interceptorcool/flyled/hw/oput/fly_ledb.png

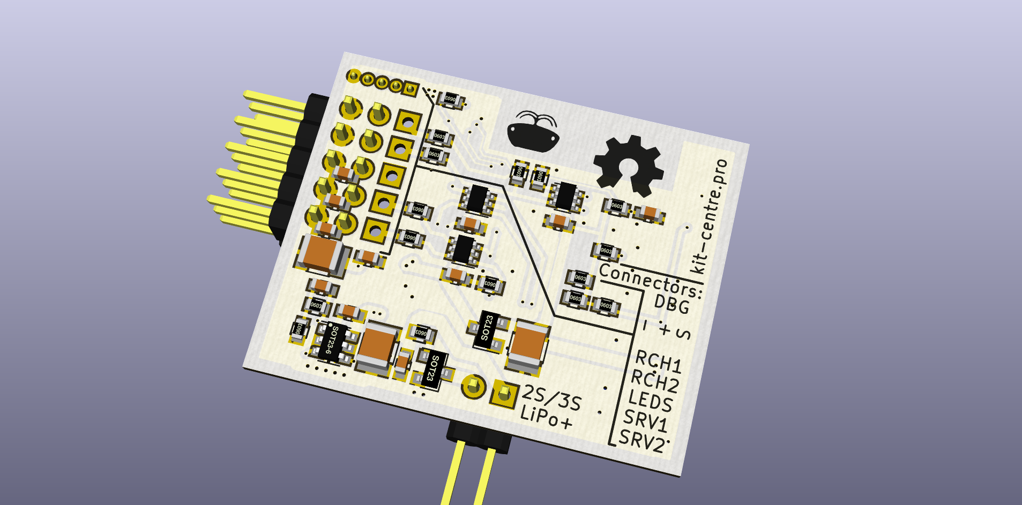
hw/oput/fly_ledb.png
