interceptorcool/flyled/hw/oput/fly_led.png

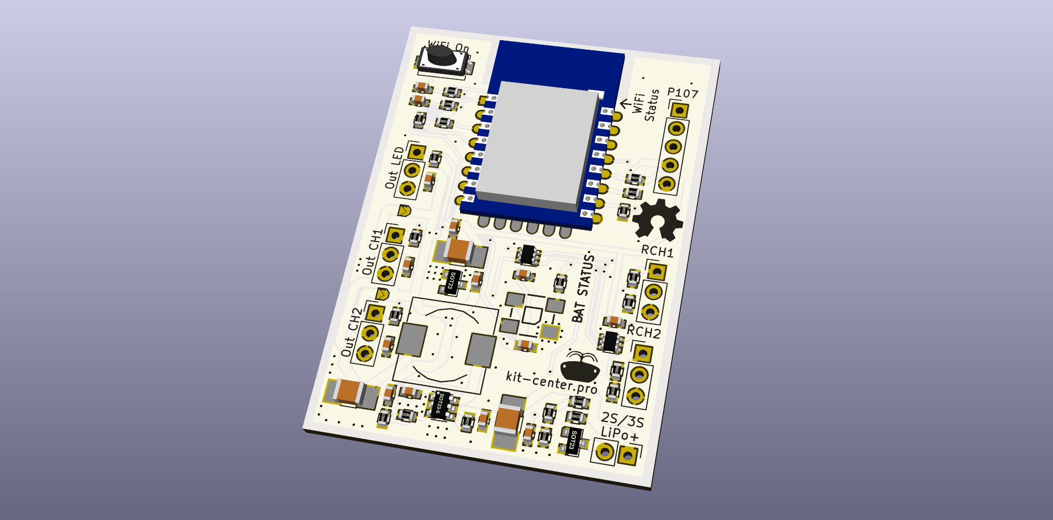
hw/oput/fly_led.png
