interceptorcool/flyled/README.md

# flyled
Fly Led controller for WS281x

# Manual for config - temp_config/conf_prototype.txt

main module esp8266

Libraries:

JsonFiles:
https://bblanchon.github.io/ArduinoJson

NeoPixelBus:
https://github.com/Makuna/NeoPixelBus

# change
global config: "INPUTS"

# add
action class: "RAND"
