interceptorcool/flyled/hw/oput/board/Снимок экрана от 2017-03-02 04:10:03.png

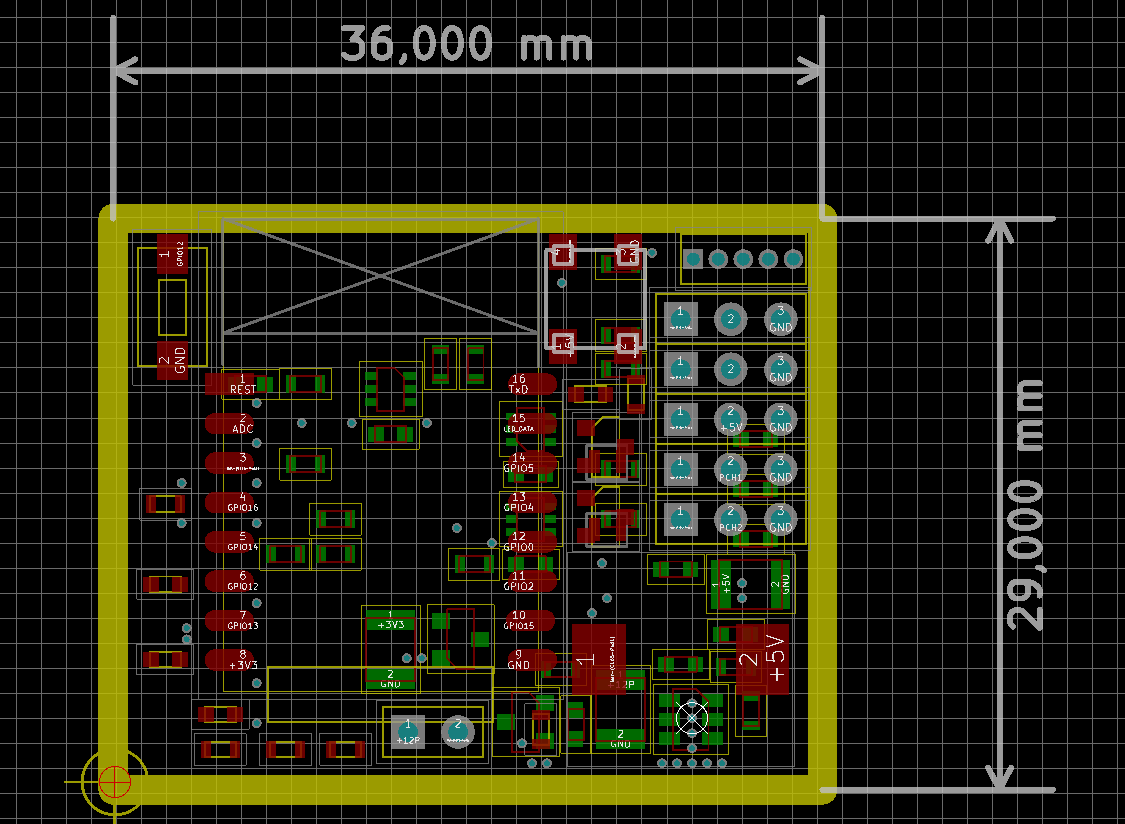
hw/oput/board/Снимок экрана от 2017-03-02 04:10:03.png
