interceptorcool/flyled/hw/oput/fly_led1.jpg

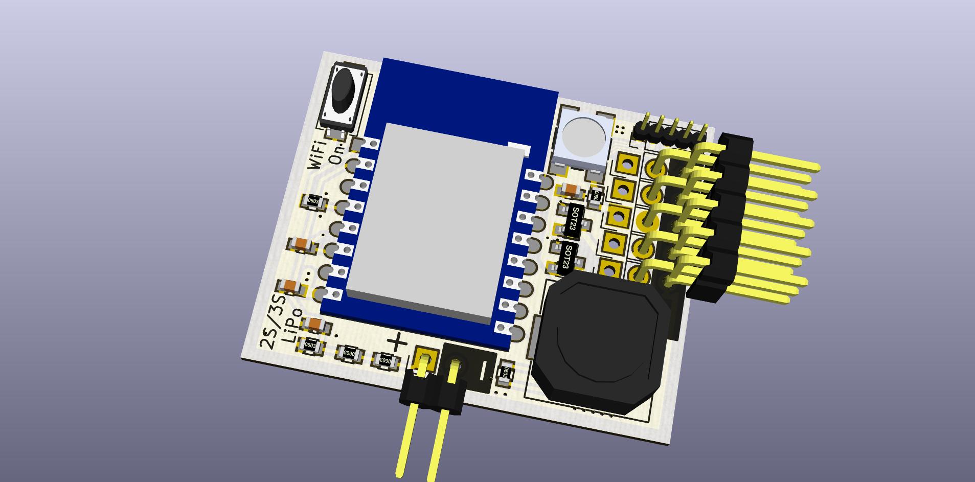
hw/oput/fly_led1.jpg
