interceptorcool/flyled/hw/oput/fly_led2.jpg

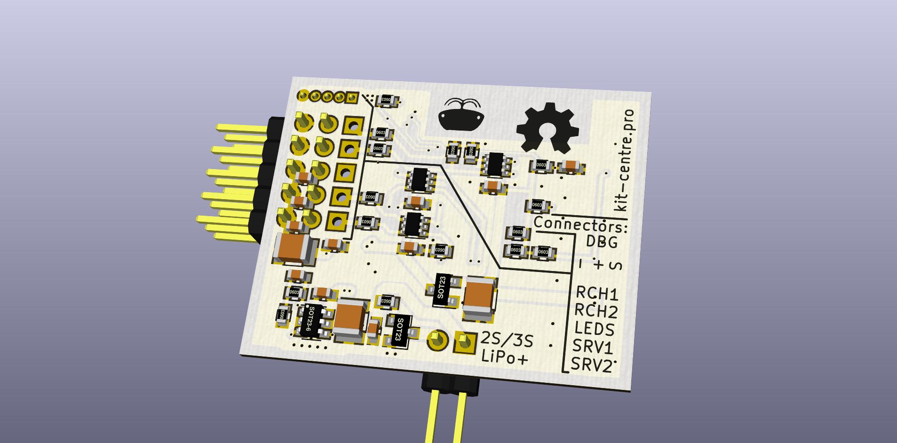
hw/oput/fly_led2.jpg
