interceptorcool/flyled/hw/oput/fly_ledt.png

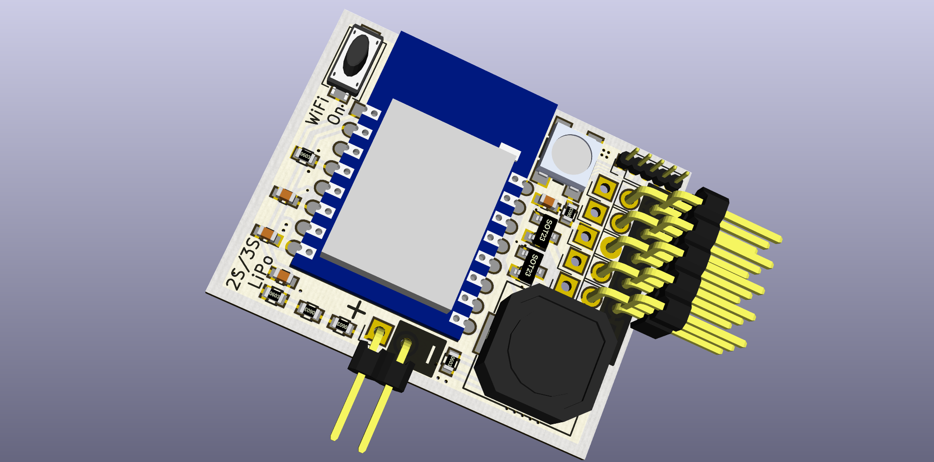
hw/oput/fly_ledt.png
