interceptorcool/flyled/hw/bom/bom1.xlsx

Reference | Value | Footprint | Datasheet | MF# | Ex
L501 | 2.2uH |  | http://www.compel.ru/infosheet/COIL/XFL4020-222MEC
U701 | MAX3222/SSOP-20 | SSOP-20 | http://www.compel.ru/infosheet/TI/MAX3222IDB
U201 | STM32L051C8T6 | LQFP48 | http://www.compel.ru/infosheet/ST/STM32L051C8T6
D501 | TLV62130 |  | http://www.compel.ru/infosheet/TI/TLV62130RGTT
D202 | TVS DIODE 15V |  | http://www.compel.ru/infosheet/ONS/MMBZ15VALT1G | LXES03AAA1-098
D601 | TVS DIODE 15V |  | http://www.compel.ru/infosheet/ONS/MMBZ15VALT1G | LXES03AAA1-098
D602 | TVS DIODE 15V |  | http://www.compel.ru/infosheet/ONS/MMBZ15VALT1G | LXES03AAA1-098
D603 | TVS DIODE 15V |  | http://www.compel.ru/infosheet/ONS/MMBZ15VALT1G | LXES03AAA1-098
D701 | TVS DIODE 15V |  | http://www.compel.ru/infosheet/ONS/MMBZ15VALT1G | LXES03AAA1-098
D702 | TVS DIODE 15V |  | http://www.compel.ru/infosheet/ONS/MMBZ15VALT1G | LXES03AAA1-098
D703 | TVS DIODE 15V |  | http://www.compel.ru/infosheet/ONS/MMBZ15VALT1G | LXES03AAA1-098
D801 | TVS DIODE 15V |  | http://www.compel.ru/infosheet/ONS/MMBZ15VALT1G | LXES03AAA1-098
D802 | TVS DIODE 15V |  | http://www.compel.ru/infosheet/ONS/MMBZ15VALT1G | LXES03AAA1-098
X201 | 32768HZ |  | http://www.compel.ru/infosheet/GEYER/KX-327NHT%2032.768%20kHz
C1001 | 0.1UF
C1002 | 0.1UF
C1003 | 0.1UF
C1004 | 0.1UF
C1201 | 0.1UF | Capacitors_SMD:C_0603
C1202 | 0.1uF | Capacitors_SMD:C_0603
C1203 | 0.1uF | Capacitors_SMD:C_0603
C1204 | 0.1uF | Capacitors_SMD:C_0603
C1205 | 0.1uF | Capacitors_SMD:C_0603
C1206 | 0.1uF | Capacitors_SMD:C_0603
C1207 | 0.1uF | Capacitors_SMD:C_0603
C1208 | 0.1uF | Capacitors_SMD:C_0603
C1211 | 0.1uF | Capacitors_SMD:C_0603
C1212 | 0.1uF | Capacitors_SMD:C_0603
C1215 | 0.1uF | Capacitors_SMD:C_0603
C201 | 0.1UF
C204 | 0.1UF
C206 | 0.1UF
C207 | 0.1UF
C208 | 0.1UF
C209 | 0.1UF
C210 | 0.1UF
C503 | 0.1UF
C605 | 0.1UF | Capacitors_SMD:C_0805
C701 | 0.1UF
C702 | 0.1UF
C703 | 0.1UF
C704 | 0.1UF
R1009 | 1.2M
R1013 | 1.2M
R1001 | 1.8M
R1004 | 1.8M
R1007 | 1.8M
R1011 | 1.8M
R1101 | 1.8M
R1102 | 1.8M
R1103 | 1.8M
R1104 | 1.8M
R1201 | 1.8M
R1301 | 1.8M
R1302 | 1.8M
R502 | 1.8M
R601 | 1.8M
R703 | 1.8M
R704 | 1.8M
R801 | 1.8M
C604 | 10PF | Capacitors_SMD:C_0805
R1010 | 130K
R1014 | 130K
R1105 | 130K
R1106 | 130K
R1211 | 130K | Resistors_SMD:R_0603
R1303 | 130K
R202 | 130K
R203 | 130K
R503 | 130K
R505 | 160K
R201 | 1K
R607 | 1K
R610 | 1K
R611 | 1K
R612 | 1K
R613 | 1K
R614 | 1K
R615 | 1K | Resistors_SMD:R_0805
C1209 | 1uF | Capacitors_SMD:C_0603
C1210 | 1uF | Capacitors_SMD:C_0603
P204 | 1W
C501 | 2200UFx10V
C202 | 22pF
C203 | 22pF
C603 | 22PF | Capacitors_SMD:C_0805
C801 | 22pF
C802 | 22pF
C205 | 22UF
C502 | 22UF
C505 | 22UF
C506 | 22UF
Q1002 | 2N7002P |  | http://www.digikey.com/product-detail/en/nexperia-usa-inc/2N7002P | 235/1727-1865-2-ND/2779619 | 2N7002P | 235
Q1004 | 2N7002P |  | http://www.digikey.com/product-detail/en/nexperia-usa-inc/2N7002P | 235/1727-1865-2-ND/2779619 | 2N7002P | 235
Q1006 | 2N7002P |  | http://www.digikey.com/product-detail/en/nexperia-usa-inc/2N7002P | 235/1727-1865-2-ND/2779619 | 2N7002P | 235
Q1101 | 2N7002P |  | http://www.digikey.com/product-detail/en/nexperia-usa-inc/2N7002P | 235/1727-1865-2-ND/2779619
Q1102 | 2N7002P |  | http://www.digikey.com/product-detail/en/nexperia-usa-inc/2N7002P | 235/1727-1865-2-ND/2779619
Q1301 | 2N7002P |  | http://www.digikey.com/product-detail/en/nexperia-usa-inc/2N7002P | 235/1727-1865-2-ND/2779619 | 2N7002P | 235
Q501 | 2N7002P |  | http://www.digikey.com/product-detail/en/nexperia-usa-inc/2N7002P | 235/1727-1865-2-ND/2779619 | 2N7002P | 235
R1006 | 300k
R1212 | 39k | Resistors_SMD:R_0603
R1203 | 4.7k | Resistors_SMD:R_0603
R1207 | 4.7k | Resistors_SMD:R_0603
R1208 | 4.7k | Resistors_SMD:R_0603
R1213 | 4.7k | Resistors_SMD:R_0603
R1214 | 4.7k | Resistors_SMD:R_0603
R204 | 4.7K
R301 | 4.7k |  |  |  | Y
R401 | 4.7k |  |  |  | Y
C1213 | 4.7uF | Capacitors_SMD:C_0603
C1214 | 4.7uF | Capacitors_SMD:C_0603
C1216 | 4.7uF | Capacitors_SMD:C_0603
R1107 | 43K
R805 | 43K
R806 | 43K
R1304 | 44R
C504 | 470PF
C601 | 470UF
C602 | 470UF
C507 | 470UFx6V
R1002 | 51R
R1003 | 51R
R1008 | 51R
R1012 | 51R
R1202 | 51R
R205 | 51R
R302 | 51R
R402 | 51R
R602 | 51R
R603 | 51R | Resistors_SMD:R_0805
R604 | 51R | Resistors_SMD:R_0805
R605 | 51R | Resistors_SMD:R_0805
R608 | 51R
R609 | 51R
R701 | 51R
R702 | 51R
R802 | 51R
R501 | 560K
R504 | 560K
R803 | 620R
R804 | 620R
R1005 | 750k
R1209 | 750k | Resistors_SMD:R_0603
R101 | 9.1K
R102 | 9.1K
R1204 | 9.1K | Resistors_SMD:R_0603
R1205 | 9.1K | Resistors_SMD:R_0603
R1206 | 9.1K | Resistors_SMD:R_0603
R1210 | 9.1K | Resistors_SMD:R_0603
R606 | 9.1K | Resistors_SMD:R_0805
R901 | 9.1K
P303 | BAT_C+
P403 | BAT_C+
P302 | BAT+
P402 | BAT+
D101 | BAT54C |  | http://www.digikey.com/product-detail/en/on-semiconductor/BAT54CLT3G/BAT54CLT3GOSTR-ND/1792157 | BAT54CLT3G
D102 | BAT54C |  | http://www.digikey.com/product-detail/en/on-semiconductor/BAT54CLT3G/BAT54CLT3GOSTR-ND/1792157 | BAT54CLT3G
D103 | BAT54C |  | http://www.digikey.com/product-detail/en/on-semiconductor/BAT54CLT3G/BAT54CLT3GOSTR-ND/1792157 | BAT54CLT3G
D201 | BAT54C |  | http://www.digikey.com/product-detail/en/on-semiconductor/BAT54CLT3G/BAT54CLT3GOSTR-ND/1792157 | BAT54CLT3G
P301 | BATTARY_CONNECTOR
P401 | BATTARY_CONNECTOR
BT101 | BATTERY
D1001 | BAV99 |  | http://www.digikey.com/product-detail/en/diodes-incorporated/BAV99-13-F/BAV99-13-FDI-ND/4249870 | BAV99-13-F
D1002 | BAV99 |  | http://www.digikey.com/product-detail/en/diodes-incorporated/BAV99-13-F/BAV99-13-FDI-ND/4249870 | BAV99-13-F
D1003 | BAV99 |  | http://www.digikey.com/product-detail/en/diodes-incorporated/BAV99-13-F/BAV99-13-FDI-ND/4249870 | BAV99-13-F
D1004 | BAV99 |  | http://www.digikey.com/product-detail/en/diodes-incorporated/BAV99-13-F/BAV99-13-FDI-ND/4249870 | BAV99-13-F
D1005 | BAV99 |  | http://www.digikey.com/product-detail/en/diodes-incorporated/BAV99-13-F/BAV99-13-FDI-ND/4249870 | BAV99-13-F
P201 | BOOT
P702 | COM_EN_PWR
P701 | COM_RCV
P207 | CONN_01X05-PRG
P605 | CONN_02X03 | Pin_Headers:Pin_Header_Straight_2x03
P1205 | CONN_02X10
P1206 | CONN_02X10
J701 | DB9-DCE
P502 | DC_EN
P503 | DC_GND
P501 | DC_IN
P504 | DC_OUT
P1301 | DCHG_C
P1303 | DCHG_I-
P1302 | DCHG_I+
D1203 | ESDA5V3SC5 | tgenn:SOT23-5
D1204 | ESDA5V3SC5 | tgenn:SOT23-5
P101 | EXT
U1201 | FSA2567 | tgenn:MLP16B
P1202 | G_En
P1203 | G_GND
P1204 | G_PWR
P1201 | G_PWR_IN
GS1201 | GS2 | icool:Jumper_SOL
GS1202 | GS2 | icool:Jumper_SOL
GS1203 | GS2 | icool:Jumper_SOL
GS1204 | GS2 | icool:Jumper_SOL
P602 | GSM_EN
P603 | GSM_PWR
P601 | GSM_PWR_IN
P202 | I2C_SCL
P203 | I2C_SDA
P802 | IN1
P803 | IN2
Q601 | irlml9303
Q1001 | IRML9303TR |  | http://www.digikey.com/product-detail/en/diodes-incorporated/DMG2301L-13/DMG2301L-13-ND/5768496 | DMG2301L-13
Q1003 | IRML9303TR |  | http://www.digikey.com/product-detail/en/diodes-incorporated/DMG2301L-13/DMG2301L-13-ND/5768496 | DMG2301L-13
Q1005 | IRML9303TR |  | http://www.digikey.com/product-detail/en/diodes-incorporated/DMG2301L-13/DMG2301L-13-ND/5768496 | DMG2301L-13
Q1103 | IRML9303TR |  | http://www.digikey.com/product-detail/en/diodes-incorporated/DMG2301L-13/DMG2301L-13-ND/5768496 | DMG2301L-13
Q1104 | IRML9303TR |  | http://www.digikey.com/product-detail/en/diodes-incorporated/DMG2301L-13/DMG2301L-13-ND/5768496 | DMG2301L-13
Q1105 | IRML9303TR |  | http://www.digikey.com/product-detail/en/diodes-incorporated/DMG2301L-13/DMG2301L-13-ND/5768496 | DMG2301L-13
Q1106 | IRML9303TR |  | http://www.digikey.com/product-detail/en/diodes-incorporated/DMG2301L-13/DMG2301L-13-ND/5768496 | DMG2301L-13
Q1201 | IRML9303TR |  | http://www.digikey.com/product-detail/en/diodes-incorporated/DMG2301L-13/DMG2301L-13-ND/5768496 | DMG2301L-13
Q1302 | IRML9303TR |  | http://www.digikey.com/product-detail/en/diodes-incorporated/DMG2301L-13/DMG2301L-13-ND/5768496 | DMG2301L-13
Q301 | IRML9303TR |  | http://www.digikey.com/product-detail/en/diodes-incorporated/DMG2301L-13/DMG2301L-13-ND/5768496 | DMG2301L-13
Q401 | IRML9303TR |  | http://www.digikey.com/product-detail/en/diodes-incorporated/DMG2301L-13/DMG2301L-13-ND/5768496 | DMG2301L-13
Q801 | IRML9303TR |  | http://www.digikey.com/product-detail/en/diodes-incorporated/DMG2301L-13/DMG2301L-13-ND/5768496 | DMG2301L-13
JP1001 | Jumper_NO_Small
JP1002 | Jumper_NO_Small
JP1003 | Jumper_NO_Small
JP1004 | Jumper_NO_Small
JP1005 | Jumper_NO_Small
JP1006 | Jumper_NO_Small
JP1007 | Jumper_NO_Small
JP101 | Jumper_NO_Small
D301 | LED_RED
D401 | LED_RED
L1201 | LQM21FN2R2N00D | Resistors_SMD:R_0805
L1202 | LQM21FN2R2N00D | Resistors_SMD:R_0805
P1001 | M_CNTR
P1002 | M_M_VBAT1+
P1003 | M_VBAT1_G
P1004 | M_VBAT1_M
P1007 | M_VBAT1_M
P1010 | M_VBAT1_M
P1006 | M_VBAT2_G
P1009 | M_VBAT2_G
P1005 | M_VBAT2+
P1008 | M_VBAT3+
P205 | MCU_GND
P206 | MCU_PWR
U1202 | MTCH102-I/MS-ND | tgenn:MSOP-8
P901 | OUT
P902 | OUT
U901 | PC817 | DIP-4
ANT601 | PCB_ANT | tgenn:PCB_ANTENNA_PAD
P604 | RF_SYNC
P1102 | S_BAT1
P1101 | S_BAT2
P1105 | S_BATO
P1103 | S_CNT0
P1104 | S_CNT1
P801 | S_CNTR
D1201 | SIM_LED
U601 | SIM800H | tgenn:SIM800H
D1202 | STM_LED
S1203 | TSensor_A | Connect:PINTST
S1202 | TSensor_B | Connect:PINTST
S1201 | TSensor_C | Connect:PINTST
OLED1201 | UG-2864HSWEG01 | tgenn:UG-2864HXXX
JP1101 | USB_PON
SK1201 | WM9364CT-ND | tgenn:USIM-MOLEX-0786463001
SK1202 | WM9364CT-ND | tgenn:USIM-MOLEX-0786463001
