interceptorcool/flyled/hw/bom/fly_led.ods

Reference | Quantity | 50 | Package | Value | WorkInfo | AddInfo | Manf# | Manufacture | Specification | RU | errta | MountSide | OR | MF# | DI | PT
U2;U3 | 2 | 100 |  | 74LVC2G34_VCC
U102 | 1 | 50 |  | ESP-12E
U101 | 1 | 50 |  | AP2210N-3.3TRE1
U1 | 1 | 50 |  | 74LVC2G34_VCC |  |  |  |  |  |  |  |  | SN74LVC2G34DCKR
SW101 | 1 | 50 |  | SW_SOFT_POINT |  |  |  |  |  |  |  |  | (TS-1143HSL-180-003) | SWT-10
R122 | 1 | 50 |  | 330R |  |  |  |  |  |  |  |  |  |  |  | NP
R116;R118;R120;R119;R121;R117;R110;R102;R104;R106;R108 | 11 | 550 |  | 10k
R115 | 1 | 50 |  | 15k
R114;R109 | 2 | 100 |  | 110k
R111;R112;R101;R113;R107;R103;R105 | 8 | 400 |  | 330R
Q102;Q103 | 2 | 100 |  | Q_PMOS_GSD
Q101 | 1 | 30 |  | DMG3420U
PJ101;PJ102 | 2 | 100 |  | PJP |  |  |  |  |  |  |  |  | http://www.electronshik.ru/item/plt-81-46636
P107 | 1 | 50 |  | PRG |  |  |  |  |  |  |  |  | Бурый Медведь PLT-81
P106 | 1 | 50 |  | LED_STRIP
P105 | 1 | 50 |  | Servo_CH2
P104 | 1 | 50 |  | Servo_CH1
P103 | 1 | 50 |  | LiPo
P102 | 1 | 50 |  | RCV_CH2
P101 | 1 | 50 |  | RCV_CH1
LED101 | 1 | 50 |  | WS2812B
L101 | 1 | 30 |  | 8.2uH |  |  |  |  |  |  |  |  | IHLP2525CZER8R2M01 | SCRH105RY-8R2 | http://www.digikey.com/product-detail/en/signal-transformer/SCRH105RY-8R2/SCRH105RY-8R2-ND/277889
D101 | 1 | 30 |  | MT2492 |  |  |  |  |  |  |  |  |  | AEROSEMI
C107;C116;C103;C104;C108;C109;C110;C117;C106;C112;C114;C105;C111;C101;C118 | 15 | 750 |  | 100NF
C102;C113;C115 | 3 | 150 |  | 22u |  |  |  |  |  |  |  |  | http://www.compel.ru/infosheet/YAG/CC1210KKX7R7BB226 | CC1210KKX7R7BB226
