interceptorcool/flyled/manual/Doc1.docx

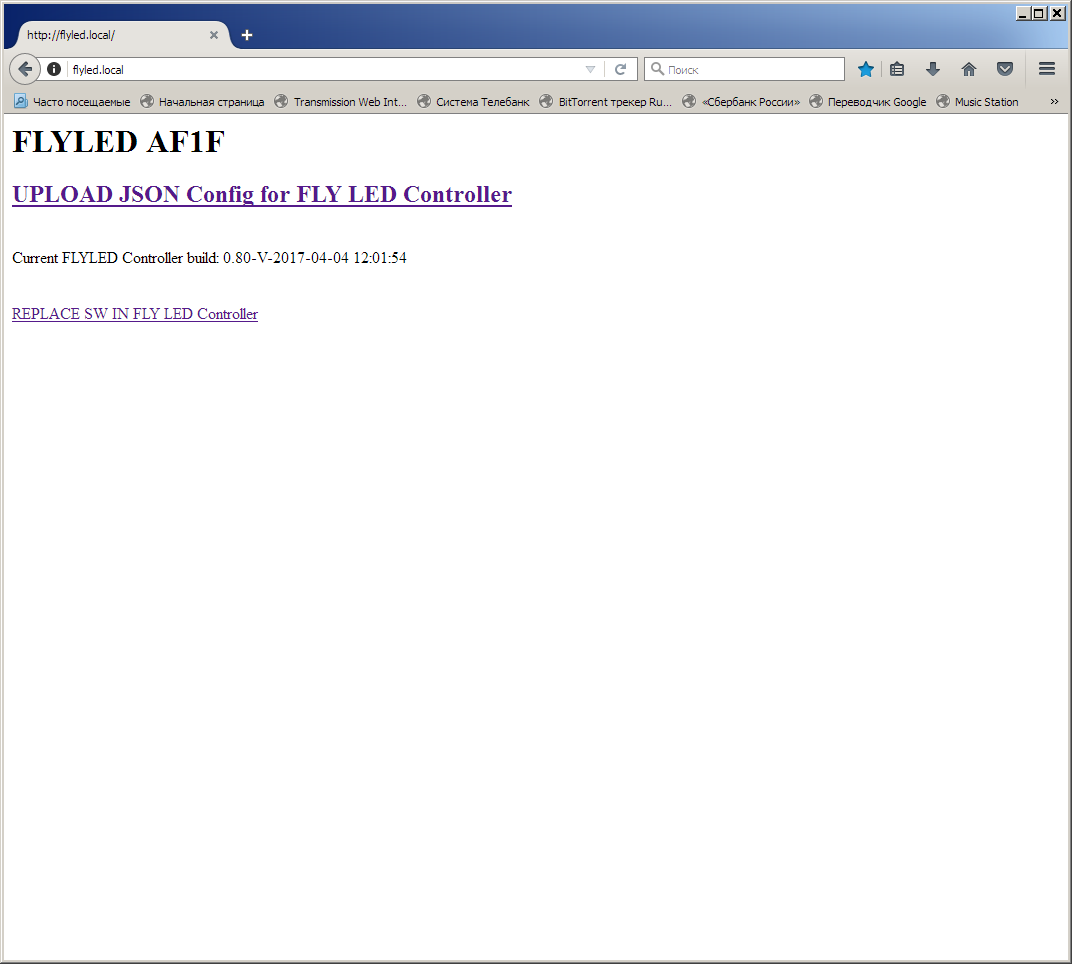
[picture p7: figure]
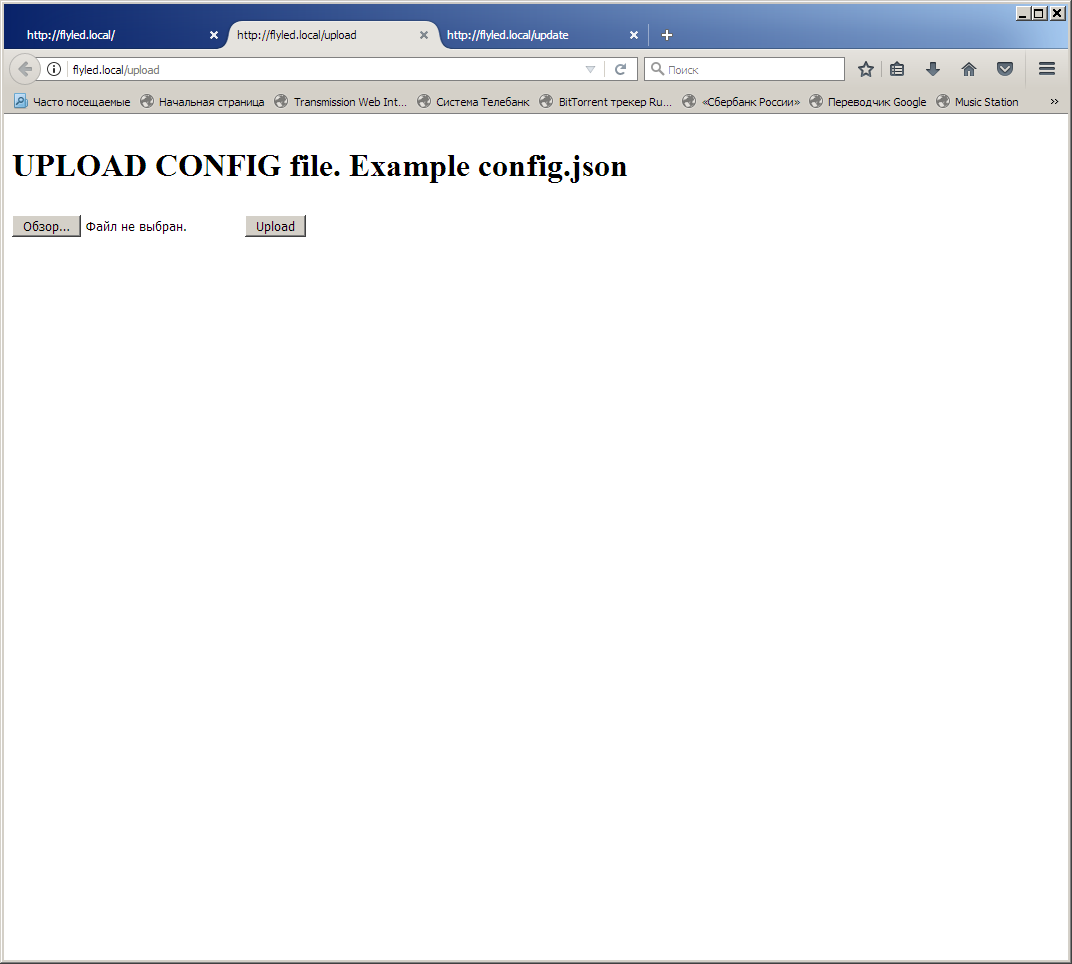
[picture p8: figure]
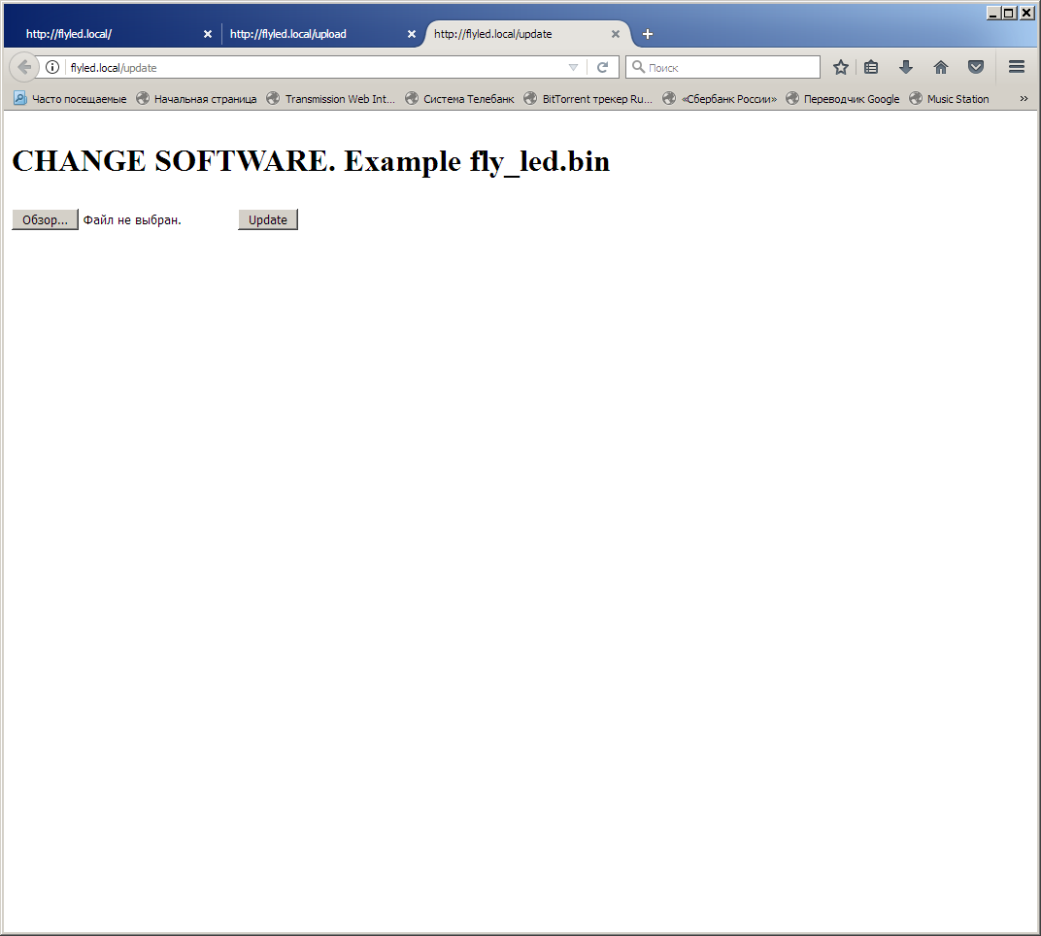
[picture p9: figure]
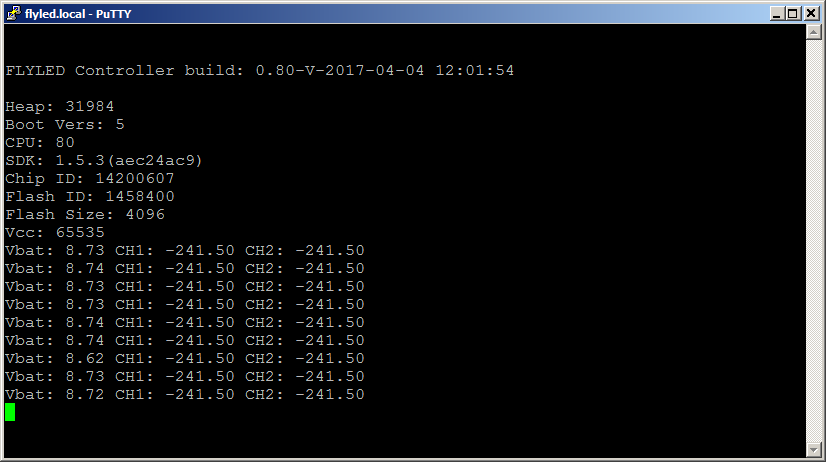
[picture p10: figure]
