interceptorcool/flyled/manual/FLYLED-manual.pdf

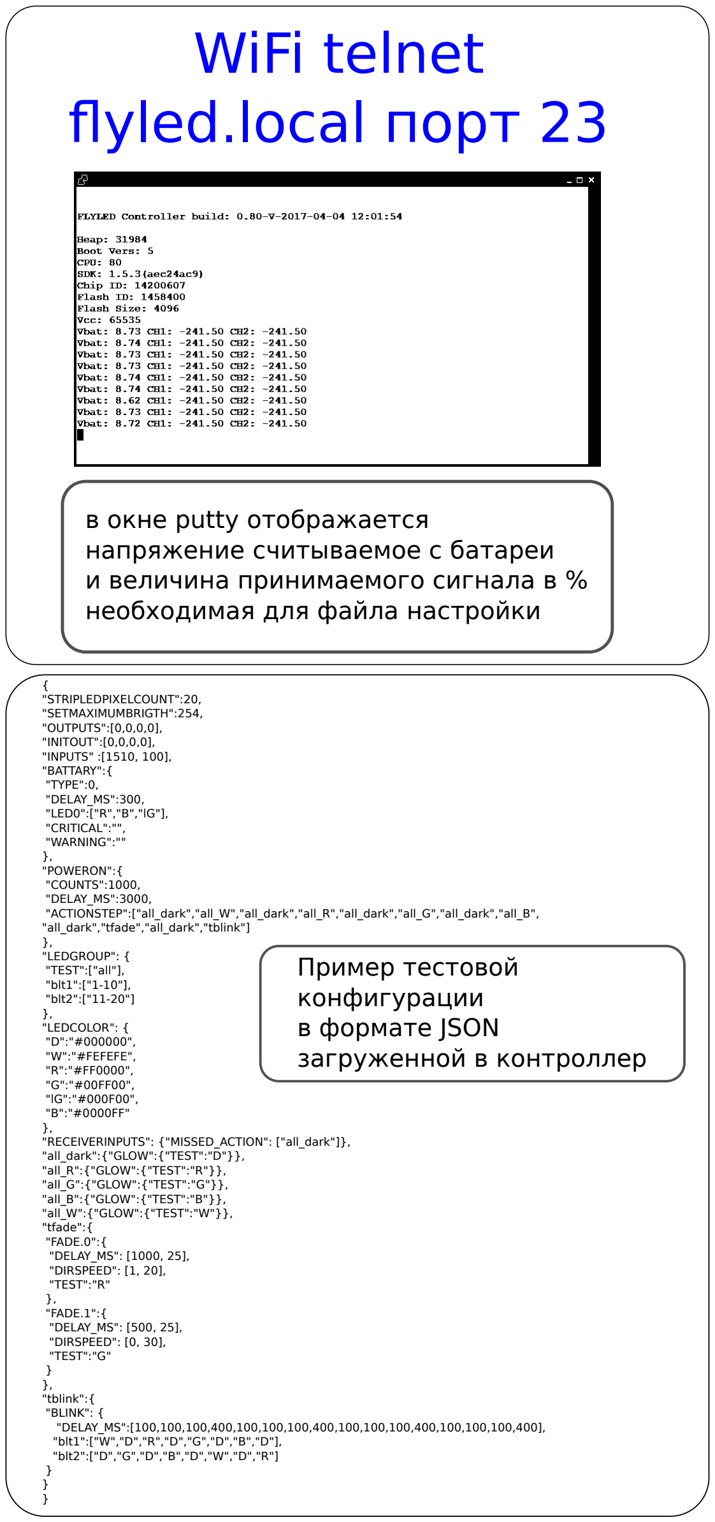
[picture p11: figure]
WiFi telnet flyled.local порт 23; в окне putty отображается напряжение считываемое с батареи и величина принимаемого сигнала в % необходимая для файла настройки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
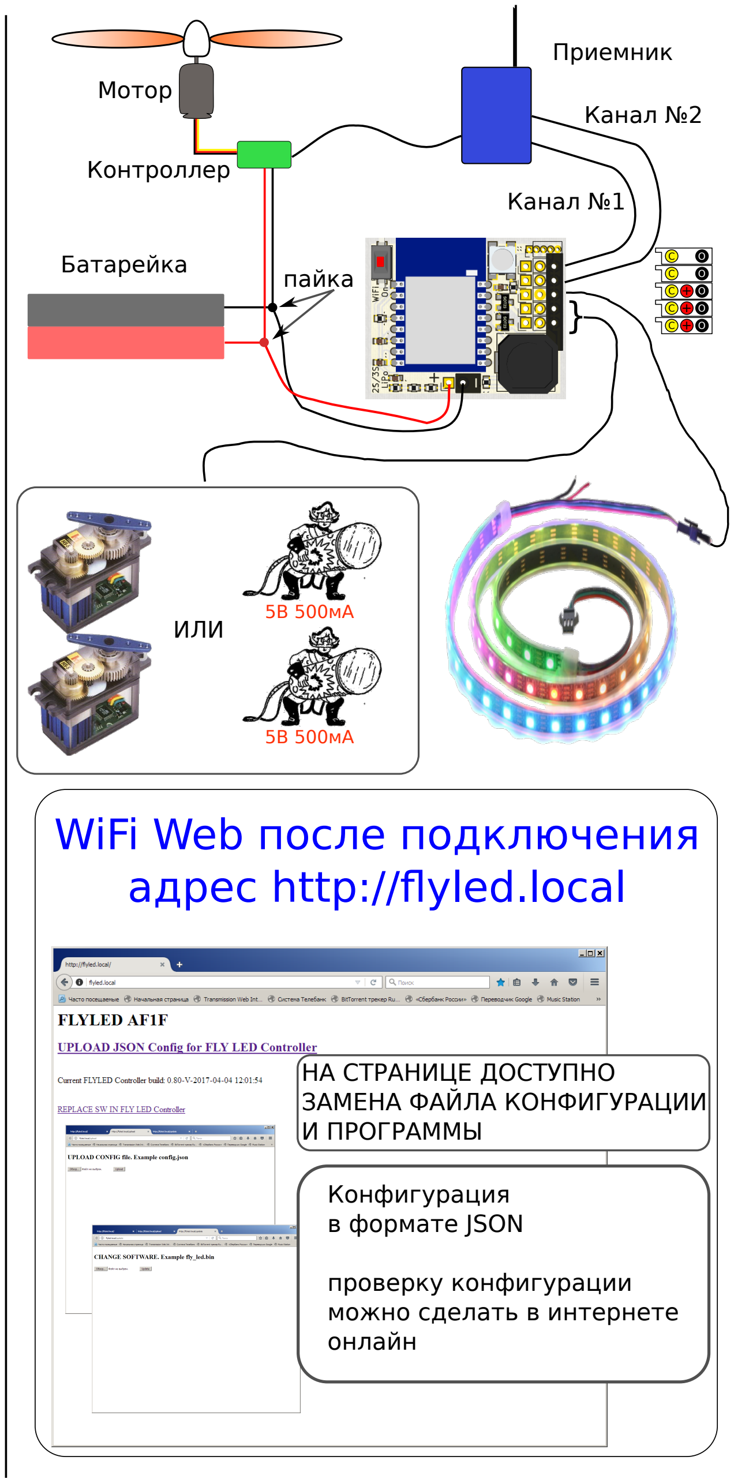
[picture p12: figure]
Контроллер; Мотор; Приемник; Батарейка; пайка; Канал №1; Канал №2; ИЛИ; WiFi Web после подключения адрес http://flyled.local; НА СТРАНИЦЕ ДОСТУПНО ЗАМЕНА ФАЙЛА КОНФИГУРАЦИИ И ПРОГРАММЫ; Конфигурация в формате JSON; проверку конфигурации можно сделать в интернете онлайн

# FLYLED Controller kit-center.pro

## КИТ ЦЕНТР

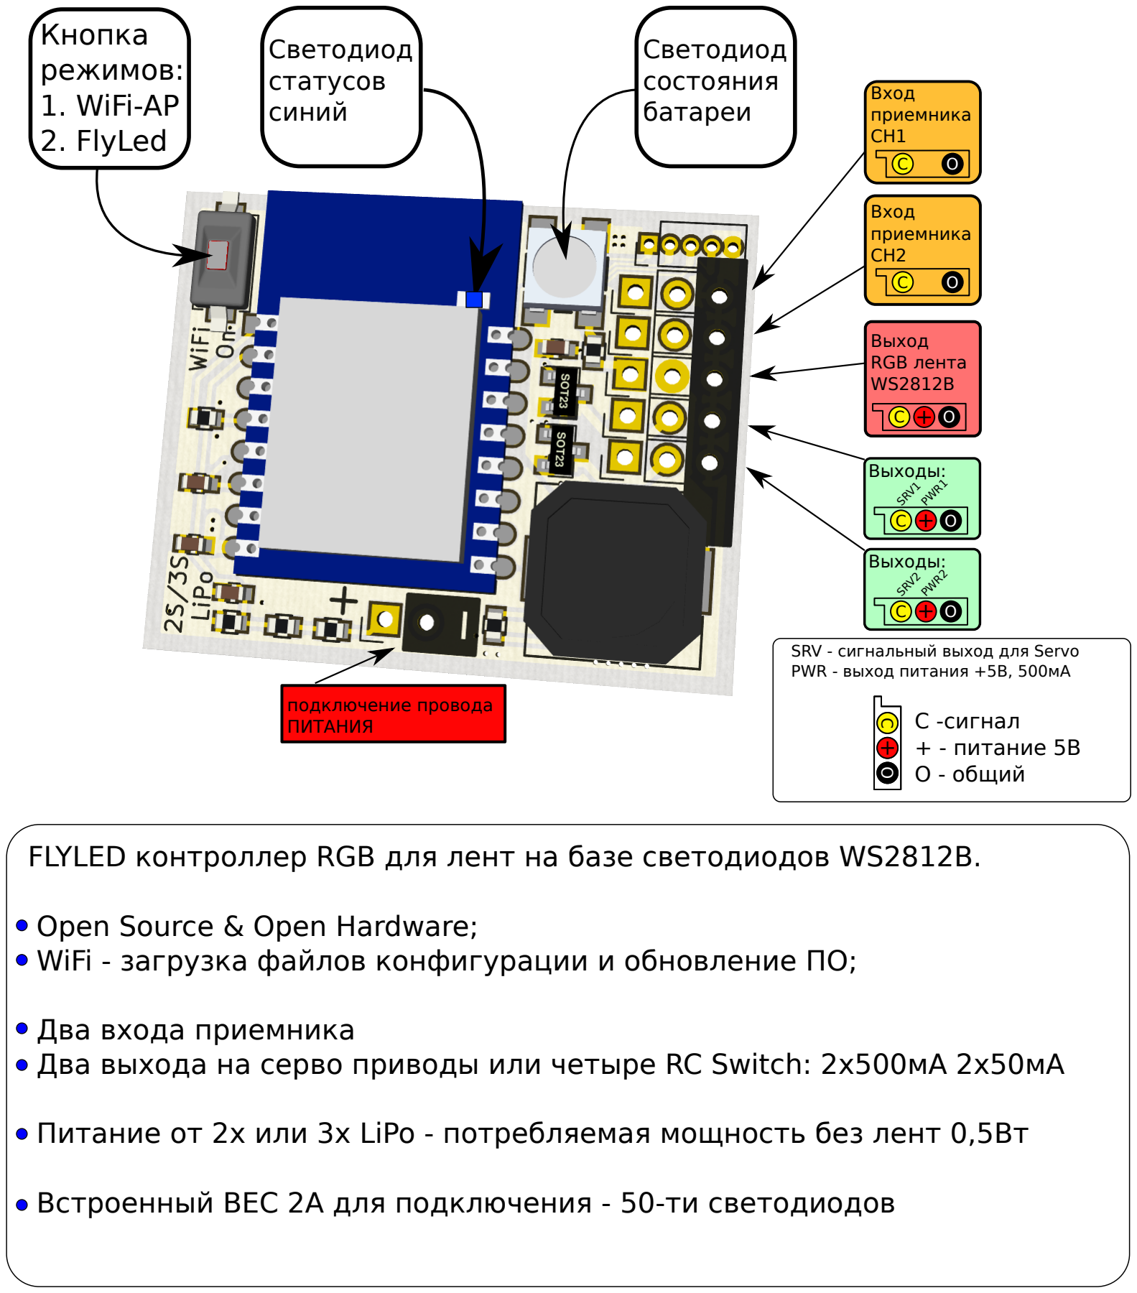
[picture p13: figure]
Кнопка режимов: 1. WiFi-AP 2. FlyLed; Светодиод состояния; батареи; Вход; приемника CH1; Вход приемника CH2; Выходы:; Выход RGB лента WS2812B; SRV1; PWR1 Выходы:; SRV2; PWR2; Светодиод статусов синий; SRV - сигнальный выход для Servo PWR - выход питания +5В, 500мА; подключение провода ПИТАНИЯ; Open Source & Open Hardware;; Два входа приемника; С -сигнал + - питание 5В О - общий

FLYLED контроллер RGB для лент на базе светодиодов WS2812B.

WiFi - загрузка файлов конфигурации и обновление ПО;

## Два выхода на серво приводы или четыре RC Switch: 2x500мА 2х50мА

## Питание от 2х или 3х LiPo - потребляемая мощность без лент 0,5Вт

## Встроенный BEC 2А для подключения - 50-ти светодиодов

# Светодиод статусов синий статусы после подачи питания 5 - 10 сек:

# 1) *.*.*.*.* - включение питания проверка файловой системы (в случае неудачи, подготовка файловой системы, примерно 30 сек)

2) *.*....*.*....*.*....*.*....*.*....*.*....*.*....*.*....*.*....*.*.... - ожидание нажатия

# кнопки WiFi, для перехода в режим WiFiAP - нажимается после подключения питания 2.a) WiFiAP: [*.*.] - ожидание подключения клиента WiFi (для подключения нужно найти сеть FLYLED XXXX) [**..**..] - подключение клиента WiFi произведено 2.б) FlyLed:

[ | *....] - очень редко мигает: ошибка в файле конфигурации или

# отсутствие такового

## поставляется как есть - GPL v3.0 настройка производится - самостоятельно ПО обновляется по мере желания автора или самостоятельно
