interceptorcool/flyled/hw/print/Монтаж.pdf

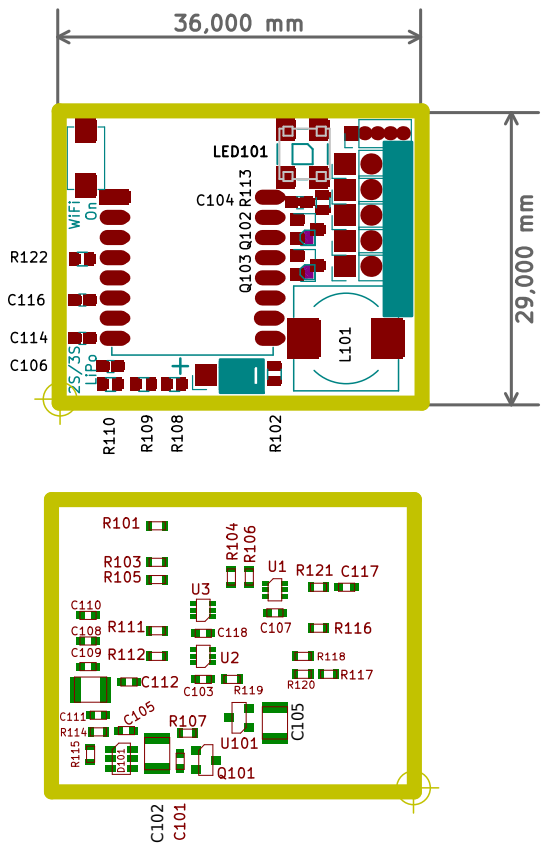
[picture p14: page 1]
