interceptorcool/flyled/hw/fly_led.kicad_pcb

## KiCad design hw/fly_led.kicad_pcb (2017-05-12)

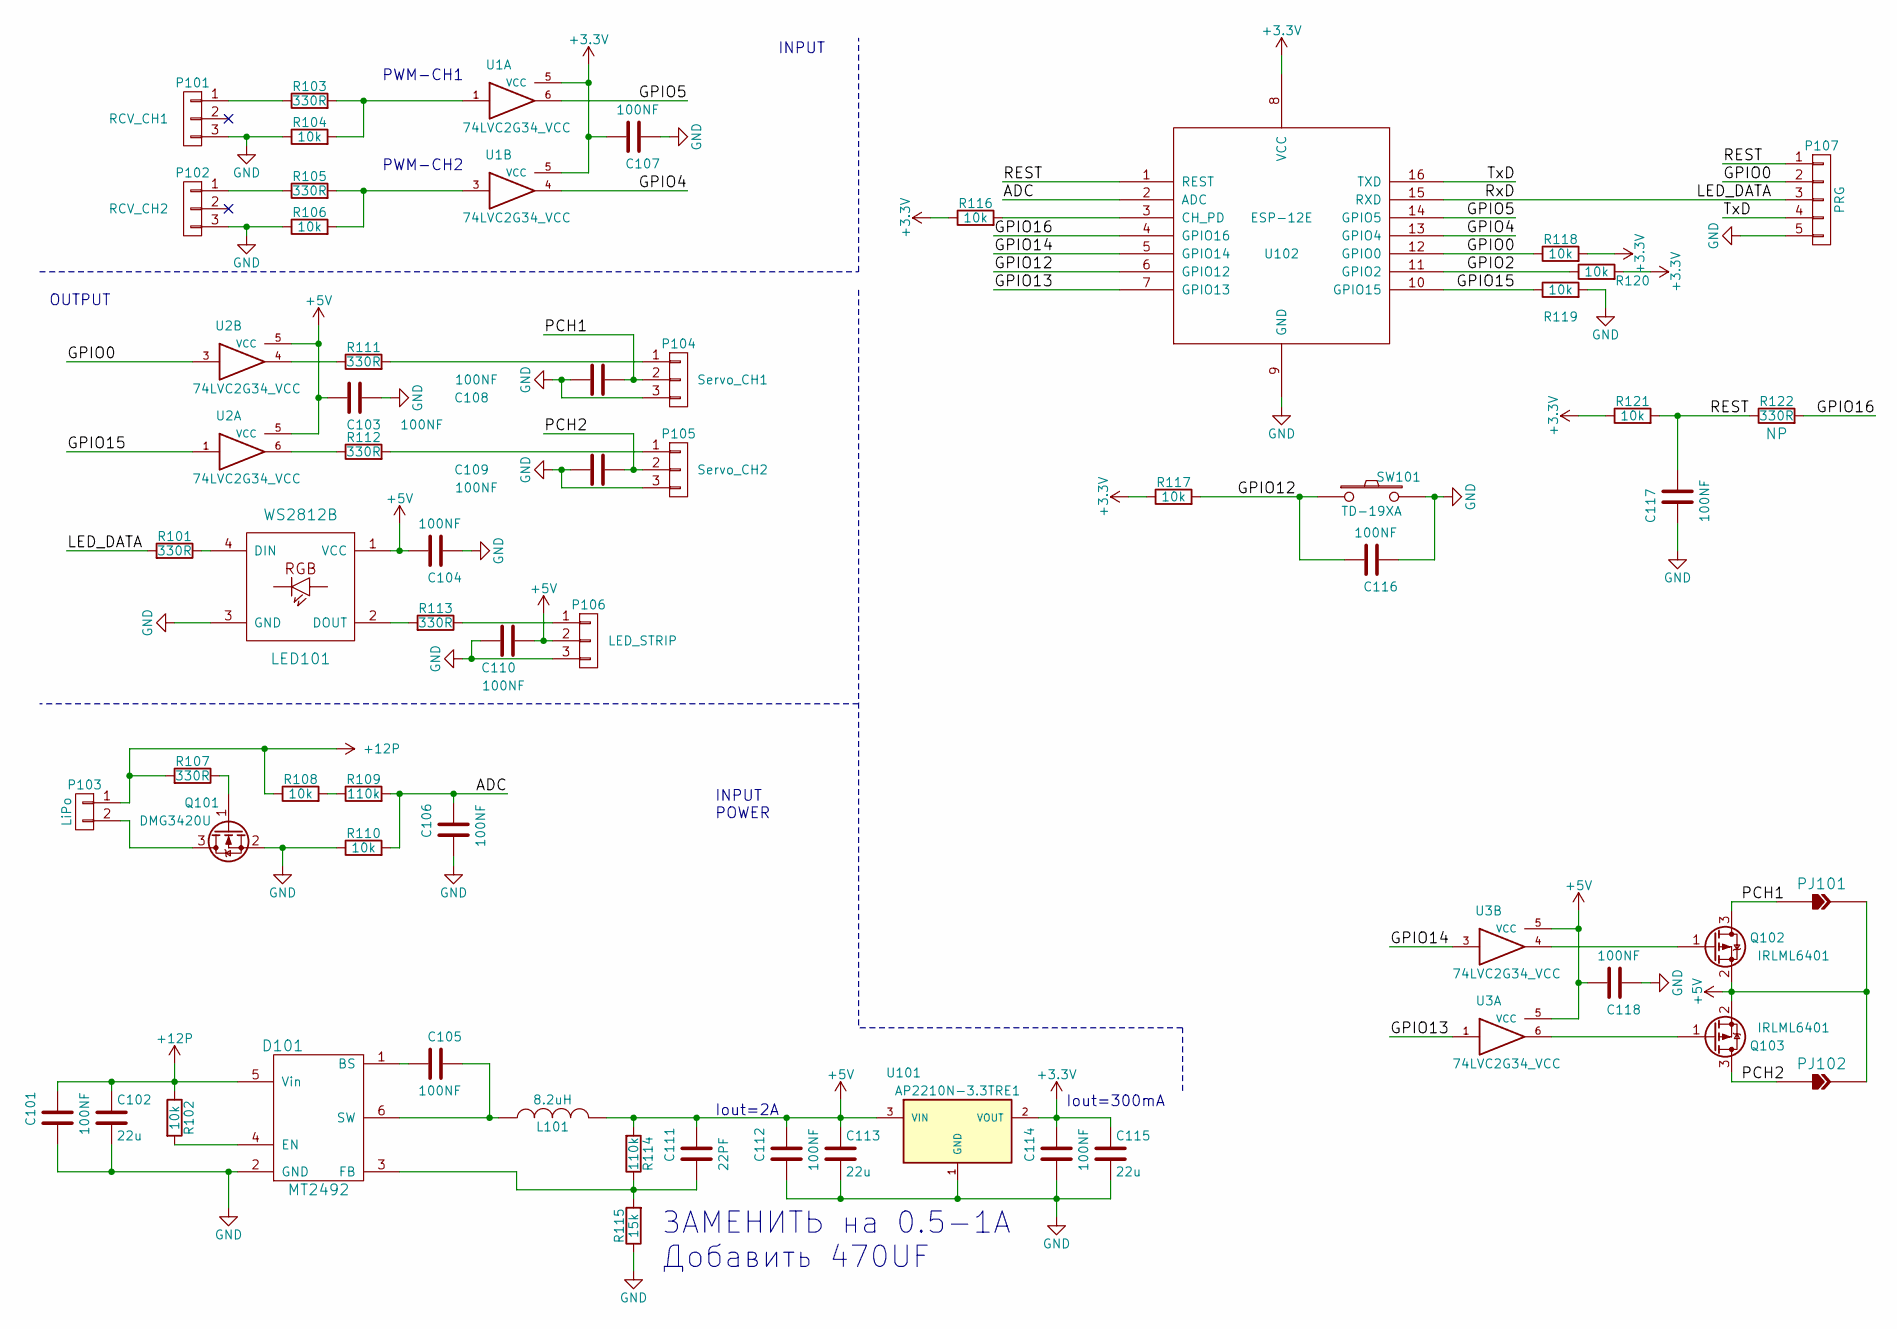
[picture p15: schematic fly_led.sch, FLYLED]

Parts:
C101, C103, C104, C105, C106, C107, C108, C109, C110, C112, C114, C116, C117, C118: 100NF; C_0603
C102, C113, C115: 22u; C_1210
C111: 22PF; C_0603
D101: MT2492; SOT-23-6
L101: 8.2uH; Choke_SMD_10.4x10.4_H4.8
LED101: WS2812B
P101: RCV_CH1; Pin_Header_Straight_1x03_Pitch2.54mm
P102: RCV_CH2; Pin_Header_Straight_1x03_Pitch2.54mm
P103: LiPo; Pin_Header_Straight_1x02_Pitch2.54mm
P104: Servo_CH1; Pin_Header_Straight_1x03_Pitch2.54mm
P105: Servo_CH2; Pin_Header_Straight_1x03_Pitch2.54mm
P106: LED_STRIP; Pin_Header_Straight_1x03_Pitch2.54mm
P107: PRG; Pin_Header_Straight_1x05_Pitch1.27mm
PJ101, PJ102: PJP; Jumper_SOL_HP
Q101: DMG3420U; SOT-23
Q102, Q103: IRLML6401; SOT-23
R101, R103, R105, R107, R111, R112, R113, R122: 330R; R_0603
R102, R104, R106, R108, R110, R116, R117, R118, R119, R120, R121: 10k; R_0603
R109, R114: 110k; R_0603
R115: 15k; R_0603
SW101: TD-19XA; SW_SPST_EVQPE1
U1, U2, U3: 74LVC2G34_VCC; SOT-363_SC-70-6
U101: AP2210N-3.3TRE1; SOT-23
U102: ESP-12E; ESP-12E-SMD

Connections:
+3V3: C107.2, C114.1, C115.1, R116.1, R117.1, R118.2, R120.2, R121.1, U1.5 (VCC), U101.2 (VOUT), U102.8 (VCC)
+5V: C103.2, C104.2, C110.2, C111.1, C112.1, C113.1, C118.2, L101.2, LED101.1 (VCC), P106.2, PJ101.2 (J2), PJ102.2 (J2), Q102.2 (S), Q103.2 (S), R114.2, U2.5 (VCC), U3.5 (VCC), U101.3 (VIN)
+12P: C101.1, C102.1, D101.5 (Vin), P103.1, R102.1, R107.2, R108.1
/ADC: C106.1, R109.2, R110.2, U102.2 (ADC)
/GPIO0: P107.2, R118.1, U2.3, U102.12 (GPIO0)
/GPIO2: R120.1, U102.11 (GPIO2)
/GPIO4: U1.4, U102.13 (GPIO4)
/GPIO5: U1.6, U102.14 (GPIO5)
/GPIO12: C116.2, R117.2, SW101.1, U102.6 (GPIO12)
/GPIO13: U3.1, U102.7 (GPIO13)
/GPIO14: U3.3, U102.5 (GPIO14)
/GPIO15: R119.1, U2.1, U102.10 (GPIO15)
/GPIO16: R122.2, U102.4 (GPIO16)
/LED_DATA: P107.3, R101.2, U102.15 (RXD)
/PCH1: C108.2, P104.2, PJ101.1 (J1), Q102.3 (D)
/PCH2: C109.2, P105.2, PJ102.1 (J1), Q103.3 (D)
/REST: C117.2, P107.1, R121.2, R122.1, U102.1 (REST)
/TxD: P107.4, U102.16 (TXD)
GND: C101.2, C102.2, C103.1, C104.1, C106.2, C107.1, C108.1, C109.1, C110.1, C112.2, C113.2, C114.2, C115.2, C116.1, C117.1, C118.1, D101.2 (GND), LED101.3 (GND), P101.3, P102.3, P104.3, P105.3, P106.3, P107.5, Q101.2 (S), R104.1, R106.1, R110.1, R115.1, R119.2, SW101.2, U1.2 (GND), U2.2 (GND), U3.2 (GND), U101.1 (GND), U102.9 (GND)
unnamed: C105.1, D101.6 (SW), L101.1
unnamed: C105.2, D101.1 (BS)
unnamed: C111.2, D101.3 (FB), R114.1, R115.2
unnamed: D101.4 (EN), R102.2
unnamed: LED101.2 (DOUT), R113.2
unnamed: LED101.4 (DIN), R101.1
unnamed: P101.1, R103.1
unnamed: P102.1, R105.1
unnamed: P103.2, Q101.3 (D)
unnamed: P104.1, R111.2
unnamed: P105.1, R112.2
unnamed: P106.1, R113.1
unnamed: Q101.1 (G), R107.1
unnamed: Q102.1 (G), U3.4
unnamed: Q103.1 (G), U3.6
unnamed: R103.2, R104.2, U1.1
unnamed: R105.2, R106.2, U1.3
unnamed: R108.2, R109.1
unnamed: R111.1, U2.4
unnamed: R112.1, U2.6
unnamed: R116.2, U102.3 (CH_PD)

Notes on the sheet:
PWM-CH1
PWM-CH2
INPUT
OUTPUT
INPUT POWER
Iout=2A
Iout=300mA
ЗАМЕНИТЬ на 0.5-1А Добавить 470UF

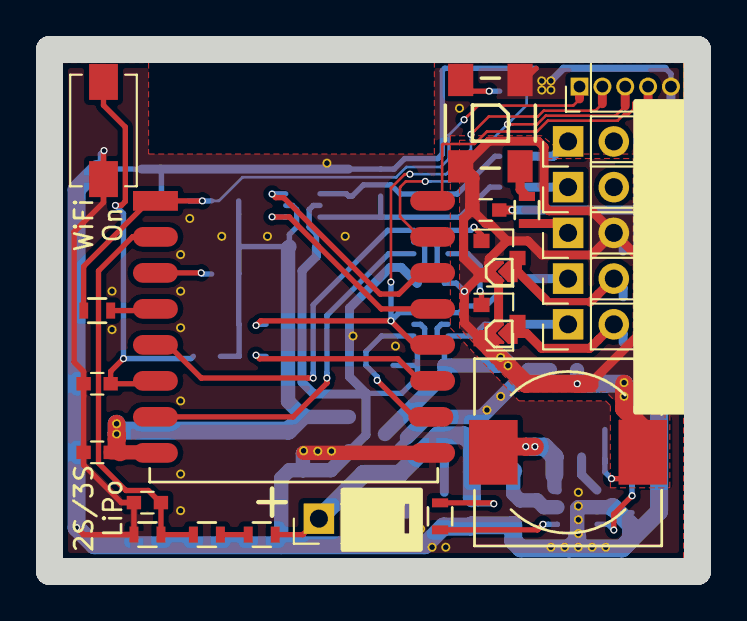
[picture p16: board fly_led.kicad_pcb from above]

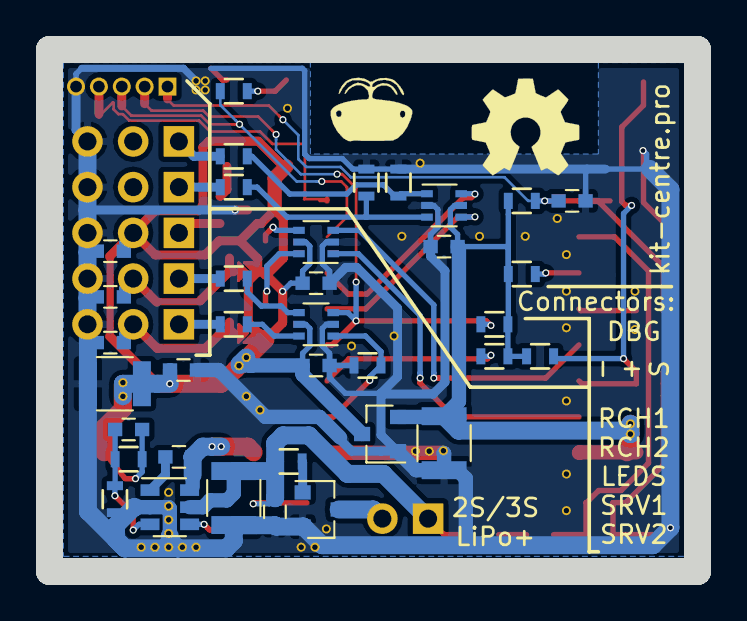
[picture p17: board fly_led.kicad_pcb from below]

Board: 2 copper layers, 36.0 x 29.0 mm, 61 parts (36 on the bottom side), 40 nets.
