interceptorcool/flyled/fly_led/version_num.h

/*
 * vertionnum.h
 *
 *  Created on: 25 мар. 2017 г.
 *      Author: icool
 */

// source file version_num.h

#ifndef VERSION_NUM_H

#define VERSION_NUM_H


#define VERSION_MAJOR 1
#define VERSION_MINOR 01


#endif // VERSION_NUM_H
